ClerckMaxwell/6T-SRAM-Design-an-Reliability-Analysis/6T_SRAM_DESIGN.pdf

# Progettazione e Analisi di una Cella SRAM a 6T

### Raffaele Petrolo

## 1 Obiettivo dell’Analisi

Il presente elaborato riguarda la progettazione e la caratterizzazione di una cella SRAM a sei transistor (6T) in tecnologia CMOS 100 nm. L’analisi si focalizza sul compromesso tra robustezza statica (margini di rumore) e dissipazione di potenza, valutando l’impatto della scalabilit`a della tensione di alimentazione fino al limite del Data Retention Voltage (DRV).

## 2 Design della Cella e Sizing degli Inverter

### 2.1 Ricerca del punto di ottimo

Inizialmente si `e cercato di ottenere inverter interni quanto pi`u simmetrici possibile. Fissata la larghezza dei Pull-down al valore minimo Wn = 0.12 µm, `e stata eseguita una simulazione parametrica variando la larghezza Wp dei transistori di Pull-up.
L’obiettivo era centrare la soglia logica della transcaratteristica (VTC) a VDD/2 = 0.5 V .

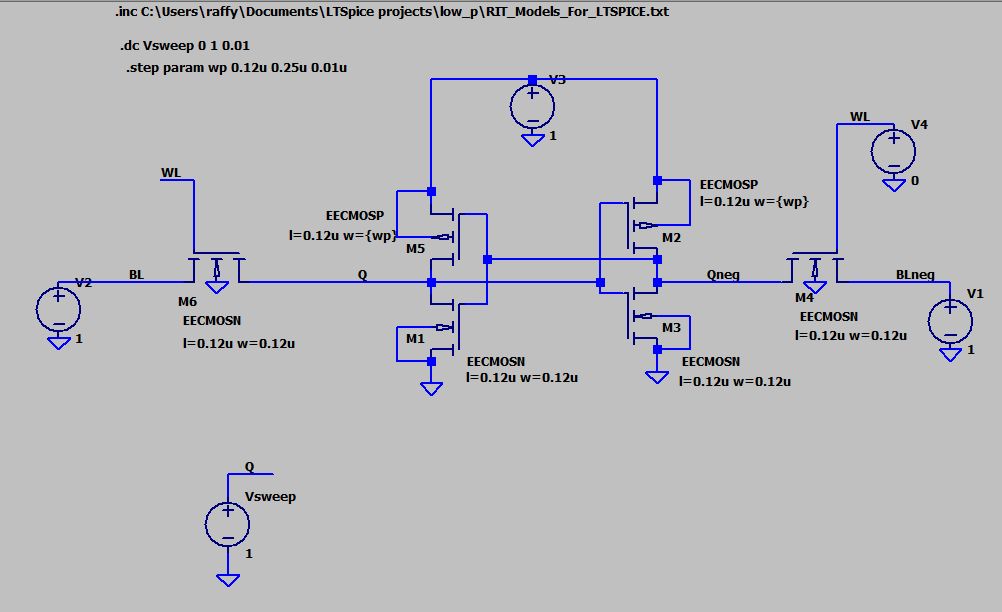
[picture p1: figure]

Figura 1: Schematico della cella 6T.

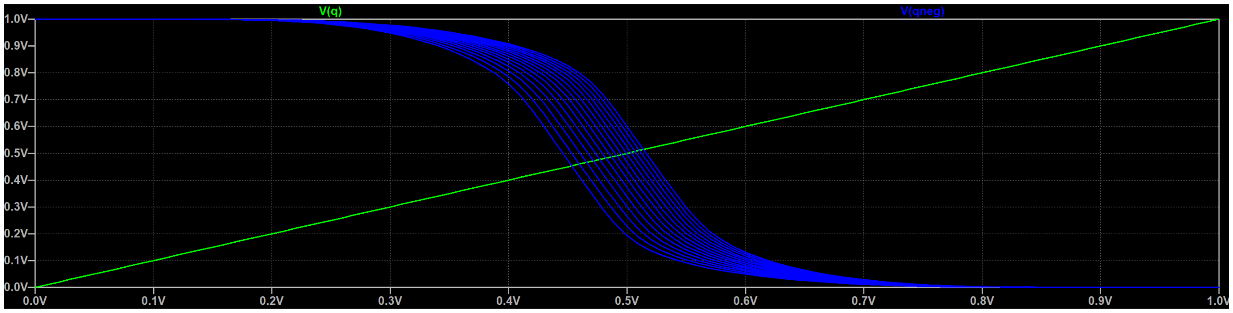
[picture p2: figure]

Figura 2: Simulazione parametrica di Wp.

Dall’analisi della Figura 2, il punto di commutazione ottimale `e stato individuato per:

| Wp = 0.21 µm
| Wn = 0.12 µm

## 3 Analisi della Stabilit`a Statica (SNM)

La stabilit`a della cella `e stata valutata tramite lo Static Noise Margin (SNM), definito come il lato del massimo quadrato inscrivibile nei lobi delle Butterfly Curves.

### 3.1 Metodologia di calcolo (Script MATLAB)

Per l’estrazione automatica dei margini di rumore, `e stato sviluppato uno script MATLAB basato sul metodo grafico della diagonale massima. Il cuore dell’algoritmo risiede nell’identificazione del massimo quadrato inscrivibile nei lobi della Butterfly Curve. Il procedimento logico-matematico `e il seguente:

1. Generazione delle curve: Partendo dai dati di simulazione (Vin, Vout), si definisce la prima curva V T C1 come y = f(x). La seconda curva V T C2, sfruttando la simmetria della cella, `e definita come l’inversa matematica x = f(y).
2. Scansione geometrica: Si considera il fascio di rette parallele alla bisettrice del primo e terzo quadrante, aventi equazione y = x + q. Per ogni valore dell’intercetta q, tale retta interseca le due curve in due punti distinti, P1 e P2.
3. Ricerca delle intersezioni: Lo script calcola per ogni punto della V T C1 il valore q = y − x. Successivamente, per un valore target di q, identifica:
| Il punto P1(x1, y1) sulla V T C1 tale per cui y1 − x1 = q.
| Il punto P2(x2, y2) sulla V T C2 tale per cui y2 − x2 = −q (sfruttando la simmetria
speculare delle curve rispetto alla bisettrice principale y = x).
4. Ottimizzazione della diagonale: La distanza euclidea d tra P1 e P2 rappresenta la diagonale di un quadrato con i lati paralleli agli assi coordinati. Lo script ricerca iterativamente il valore massimo di tale distanza (dmax) all’interno dei due lobi separatamente.
5. Calcolo dell’SNM: Poich´e in un quadrato di lato L la diagonale `e d = L

√
2, il margine
di rumore statico (Static Noise Margin) viene estratto come:

SNM =

dmax √
(1)

### 3.2 Analisi con dimensionamento iniziale

Inizialmente, la cella `e stata testata con il dimensionamento simmetrico ottenuto nel capitolo precedente (Wp = 0.21 µm, Wn = 0.12 µm) e transistor di accesso minimi (Wax = 0.12 µm). Le Figure 3a e 3b mostrano i quadrati di rumore ottenuti dallo script per le condizioni di Hold e Read.

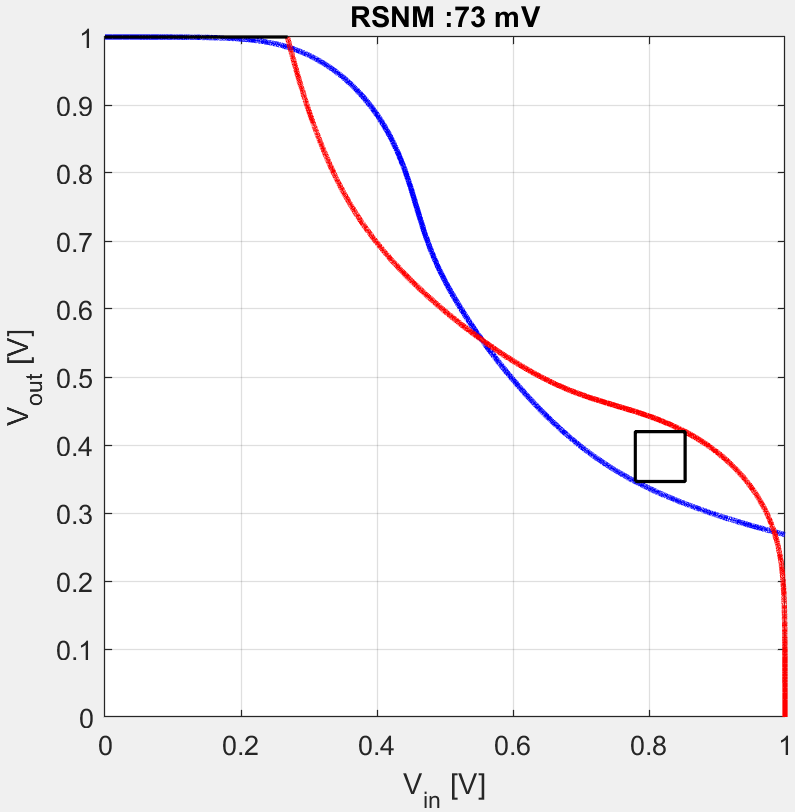
[picture p3: figure]
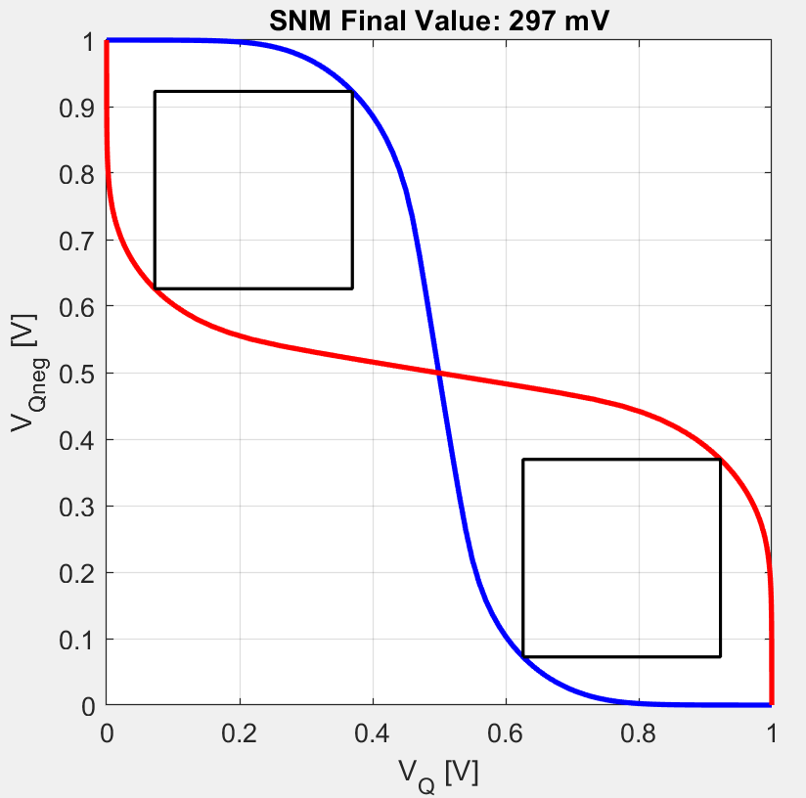
[picture p4: figure]

(a) HSNM (Hold). | (b) RSNM (Read).

Figura 3: Butterfly curves e quadrati inscritti con dimensionamento iniziale.

Sebbene l’HSNM risulti adeguato (≈ 297 mV ), l’RSNM `e troppo basso, circa 73 mV . Questa fragilit`a `e dovuta al partitore di tensione formato tra il transistor di accesso e il Pull-down durante la lettura.

### 3.3 Ottimizzazione del Beta Ratio

Per migliorare il margine di Read, si `e inizialmente valutato l’impatto di Wp. Tuttavia, i risultati mostrano che per ottenere un guadagno significativo nel margine di Read sarebbe necessario quadruplicare la larghezza del Pull-up, con un beneficio complessivo molto ridotto (Figura 4).

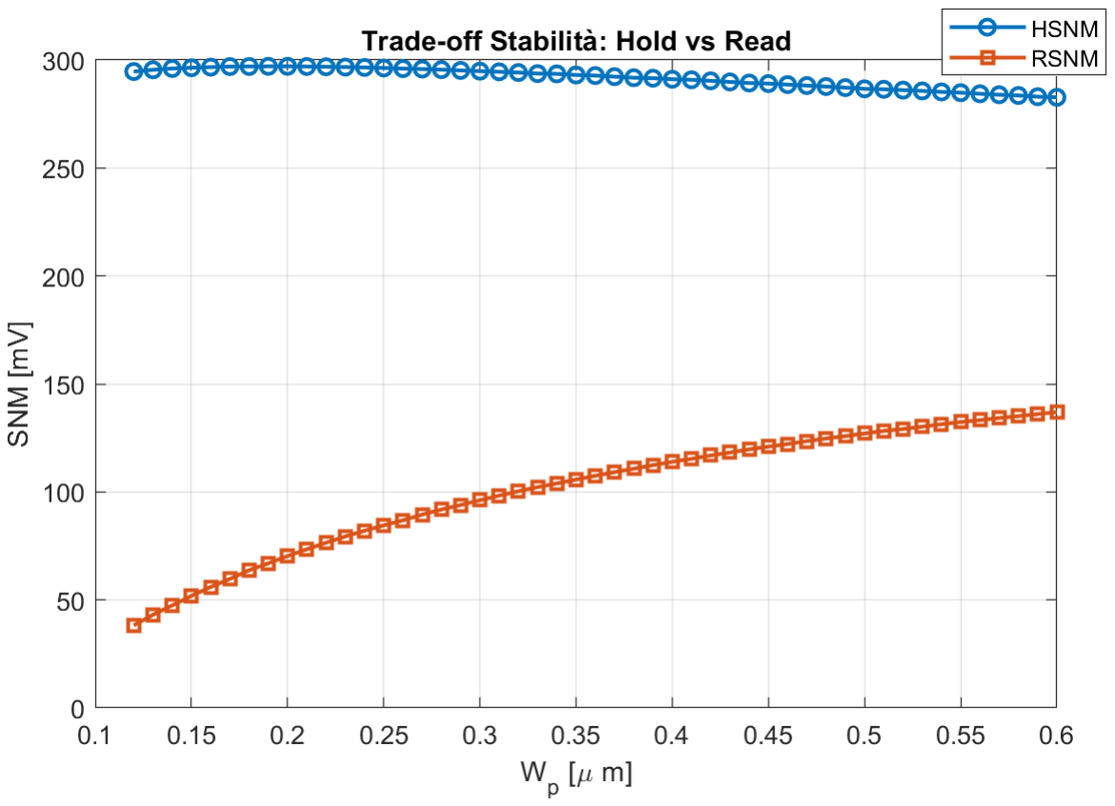
[picture p5: figure]

Figura 4: Andamento di HSNM e RSNM al variare di Wp.

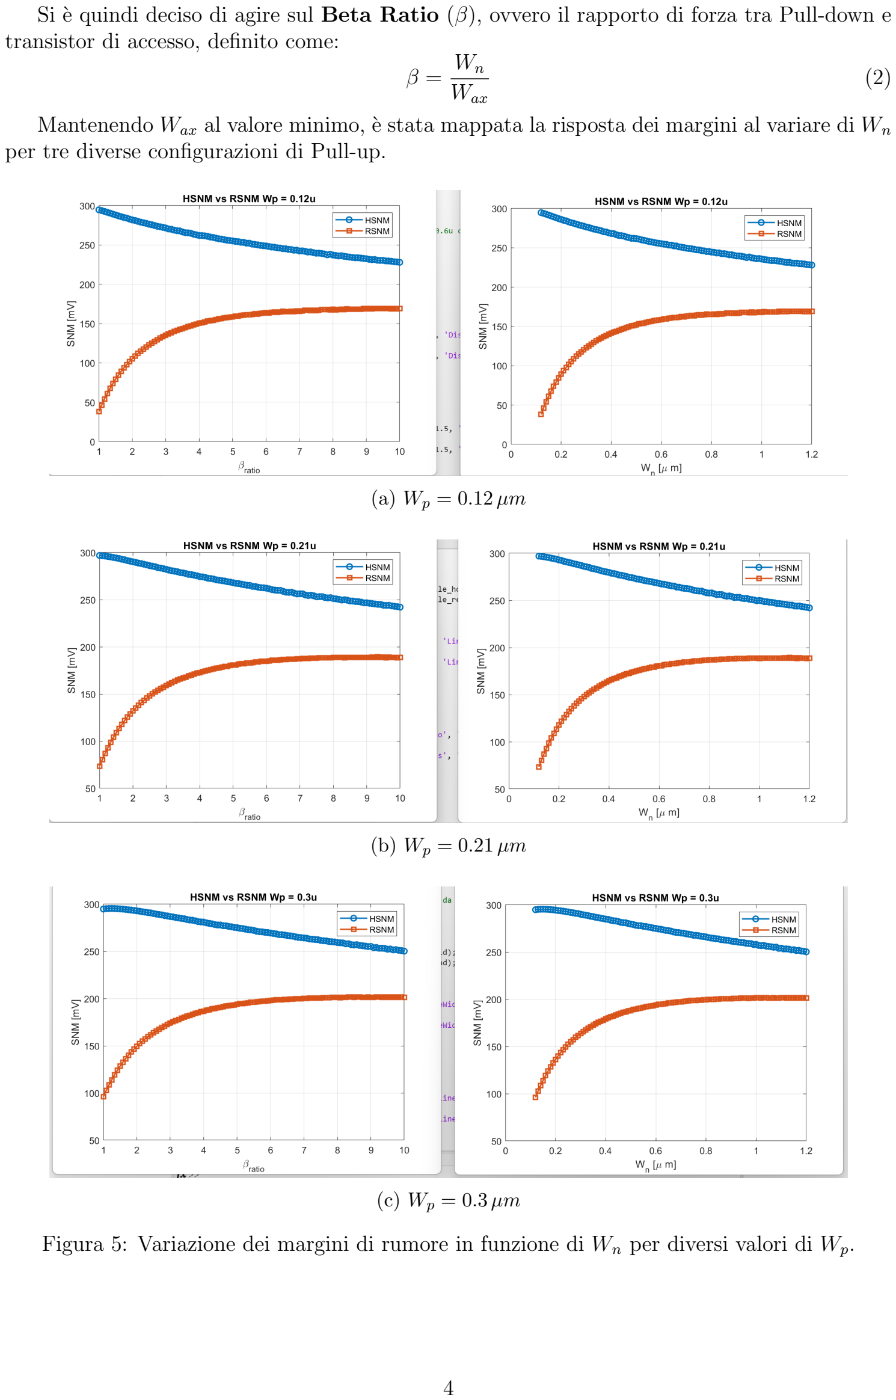
[picture p6: page 4]

Si `e quindi deciso di agire sul Beta Ratio (β), ovvero il rapporto di forza tra Pull-down e transistor di accesso, definito come:

β =

Wn

Wax

(2)

Mantenendo Wax al valore minimo, `e stata mappata la risposta dei margini al variare di Wn per tre diverse configurazioni di Pull-up.

(a) Wp = 0.12 µm
(b) Wp = 0.21 µm
(c) Wp = 0.3 µm

Figura 5: Variazione dei margini di rumore in funzione di Wn per diversi valori di Wp.

### 3.4 Scelta del dimensionamento ottimale

Dall’analisi comparativa `e emerso che l’incremento di Wp produce un offset positivo sull’RSNM estremamente ridotto a fronte di un aumento considerevole dell’area occupata. Si `e quindi scelto di mantenere il Pull-up al valore minimo tecnologico, Wp = 0.12 µm, per minimizzare l’ingombro della cella.
Per quanto riguarda il Pull-down, l’andamento dell’RSNM in funzione di Wn mostra un comportamento di tipo sub-lineare, riconducibile a una funzione radice quadrata. Per individuare il punto di massima efficacia del dimensionamento, `e stata calcolata la derivata prima dell’RSNM rispetto a Wn (Figura 6).

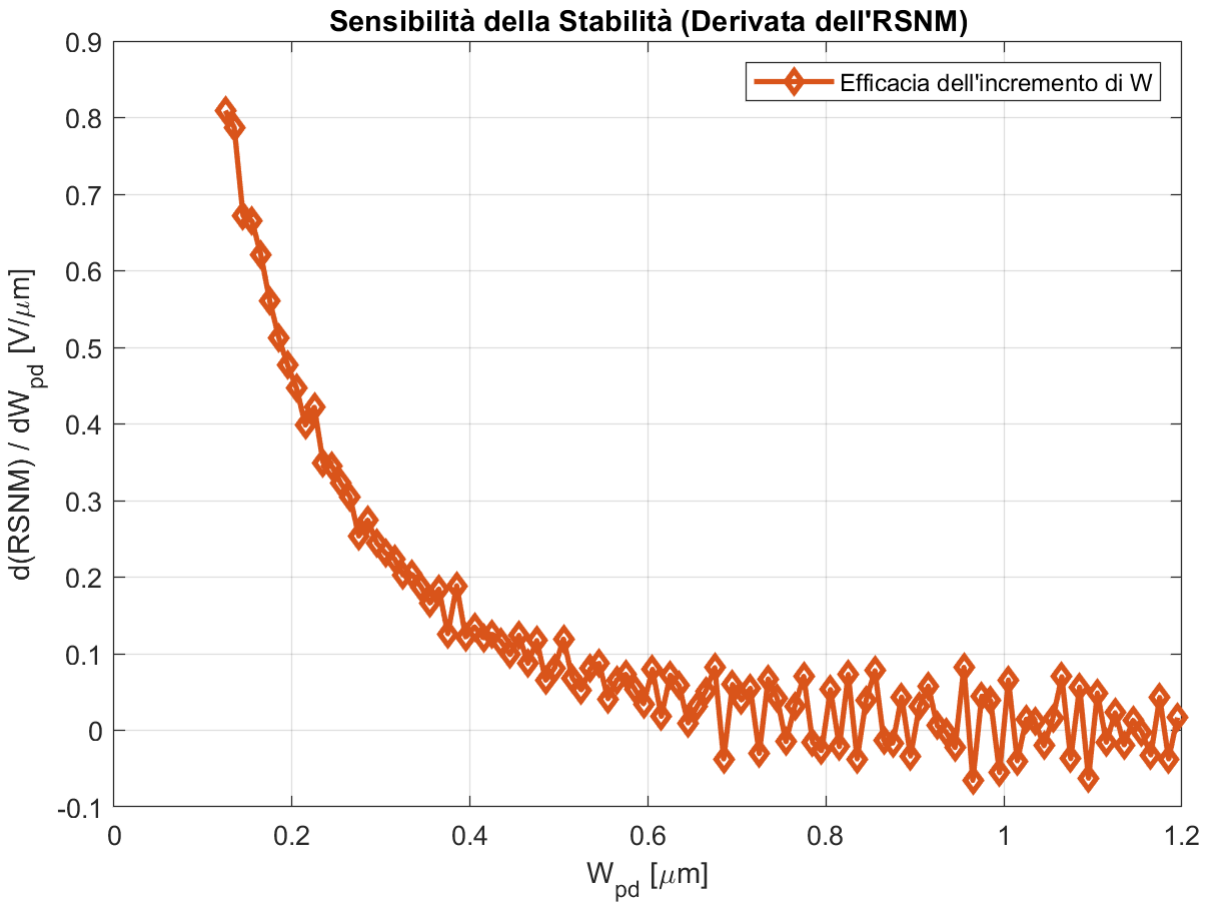
[picture p7: figure]

Figura 6: Derivata dell’RSNM rispetto a Wn. L’andamento tipico 1/

√
x conferma che i maggiori
benefici in termini di stabilit`a si ottengono per piccoli incrementi di Wn nel range iniziale.

Il grafico della derivata mostra chiaramente che la sensibilit`a del margine di rumore cala drasticamente all’aumentare della larghezza del canale. Si `e quindi individuato un punto di lavoro a Wn = 0.375 µm, che rappresenta un buon compromesso tra robustezza statica e densit`a di integrazione.

### 3.5 Impatto dei transistor di accesso e validazione del modello

Completata l’analisi sui transistor interni, si `e valutato l’impatto della larghezza dei transistor di accesso (Wax). Come previsto dalla teoria del Beta Ratio, un incremento di Wax comporta inizialmente un drastico peggioramento dell’RSNM (Figura 7).

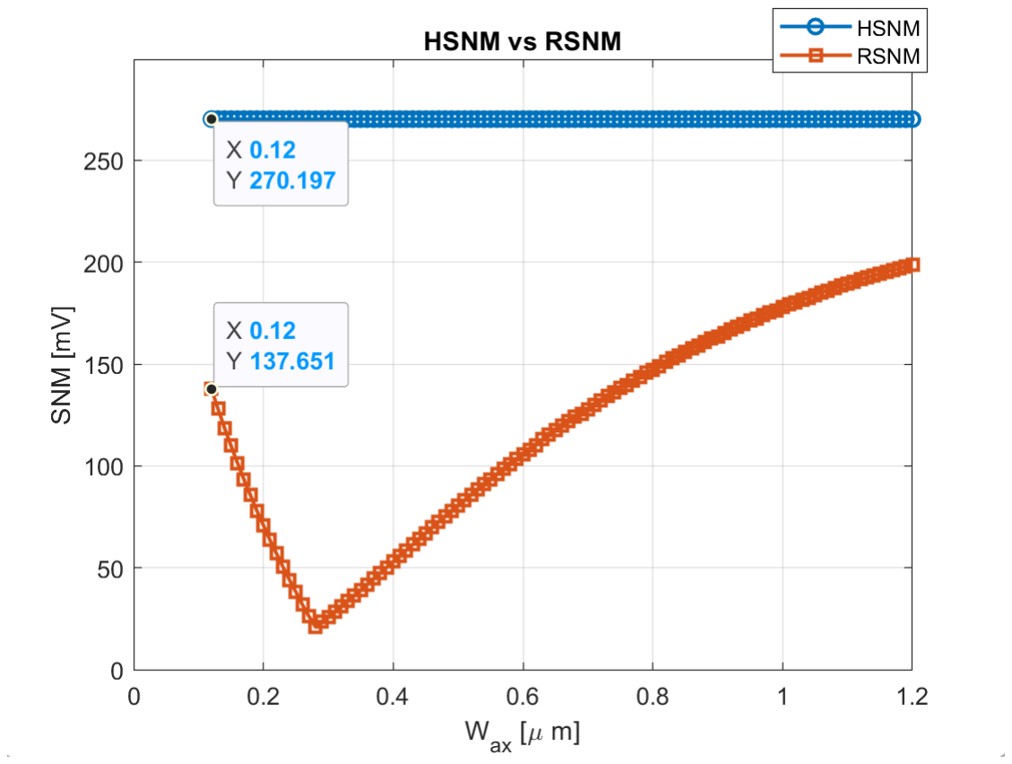
[picture p8: figure]

Figura 7: Degradazione dell’RSNM all’aumentare della larghezza dei transistor di accesso Wax.

Osservando la Figura 7, si nota un comportamento singolare: superato il punto critico in cui Wax ≈ Wn, il margine calcolato dallo script MATLAB sembra apparentemente migliorare. Tuttavia, tale incremento `e un falso positivo dovuto alla natura puramente geometrica dell’algoritmo.
Quando l’accesso diventa eccessivamente forte rispetto al Pull-down, la cella perde la sua caratteristica bistabile e le curve a farfalla si deformano al punto da non incrociarsi pi`u correttamente per formare i due lobi. Lo script continua a ricercare la massima distanza euclidea tra le curve, identificando un valore numerico elevato che per`o non rappresenta pi`u una condizione di stabilit`a, bens`ı la transizione verso un regime monostabile dove il dato viene sovrascritto dalla Bitline (read-destructive event). Per tale ragione, si `e confermato il valore minimo tecnologico Wax = 0.12 µm.
Il design finale della cella per ora presenta quindi i seguenti parametri nominali: Wp = 0.12 µm, Wn = 0.375 µm e Wax = 0.12 µm. Con tale configurazione, i margini calcolati tramite lo script MATLAB risultano:
| HSNM: 270.2 mV
| RSNM: 137.65 mV

Per validare l’accuratezza dell’algoritmo MATLAB, `e stata eseguita una verifica comparativa utilizzando il metodo di Seevnick in LTspice. Le Figure 8 e 9 mostrano la perfetta coincidenza tra i valori estratti graficamente e quelli simulati, confermando la solidit`a della procedura.

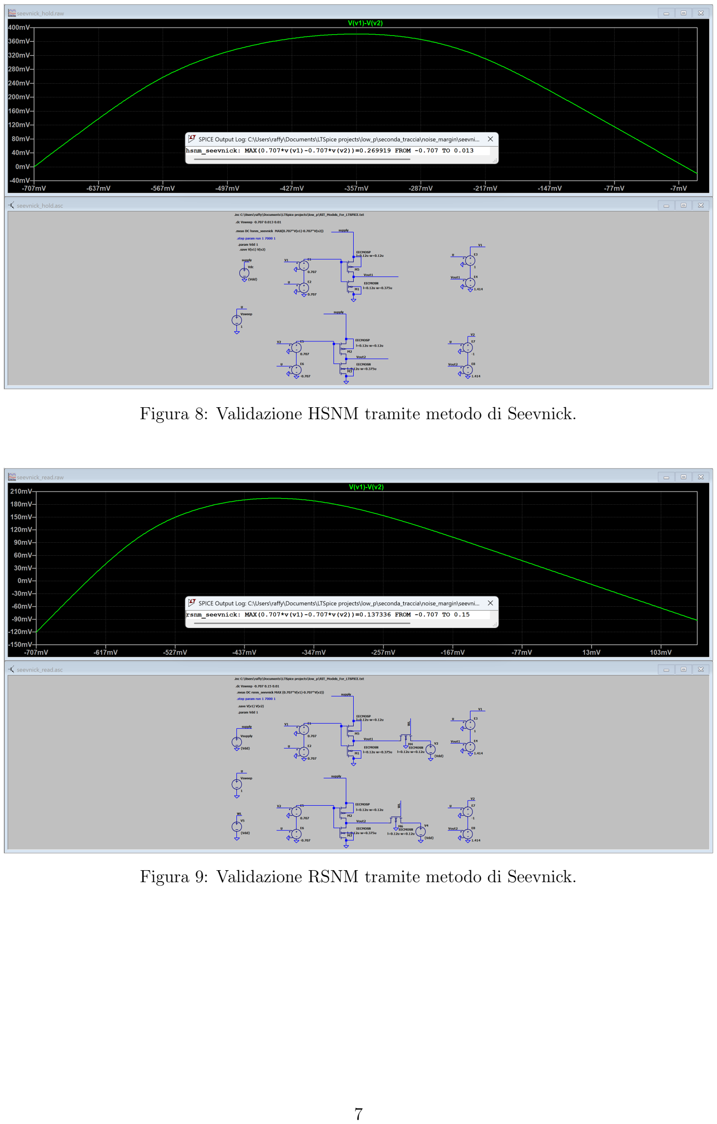
[picture p9: page 7]

Figura 8: Validazione HSNM tramite metodo di Seevnick.

Figura 9: Validazione RSNM tramite metodo di Seevnick.

## 4 Analisi statistica e Scaling della Tensione di Alimentazione

In questo capitolo viene analizzata la robustezza della cella SRAM considerando uno scaling della tensione VDD da 1 V a 0.2 V (con passi di 0.1 V ). Per ciascun valore sono state eseguite 7000 simulazioni Monte Carlo, applicando una variazione gaussiana alle tensioni di soglia (Vth) dei transistor per modellare le variazioni di processo inter-die.
L’obiettivo `e identificare il limite di funzionamento della cella, fissando una soglia critica di sicurezza SNMmin = 60 mV .

### 4.1 Ottimizzazione finale del dimensionamento

L’analisi statistica condotta sul dimensionamento precedentemente individuato (Wn = 0.375 µm) ha evidenziato una criticit`a: gi`a alla tensione nominale di 1 V , si `e riscontrato che una cella (quindi 1 su 7000) presentava un RSNM inferiore alla soglia di sicurezza di 60 mV .

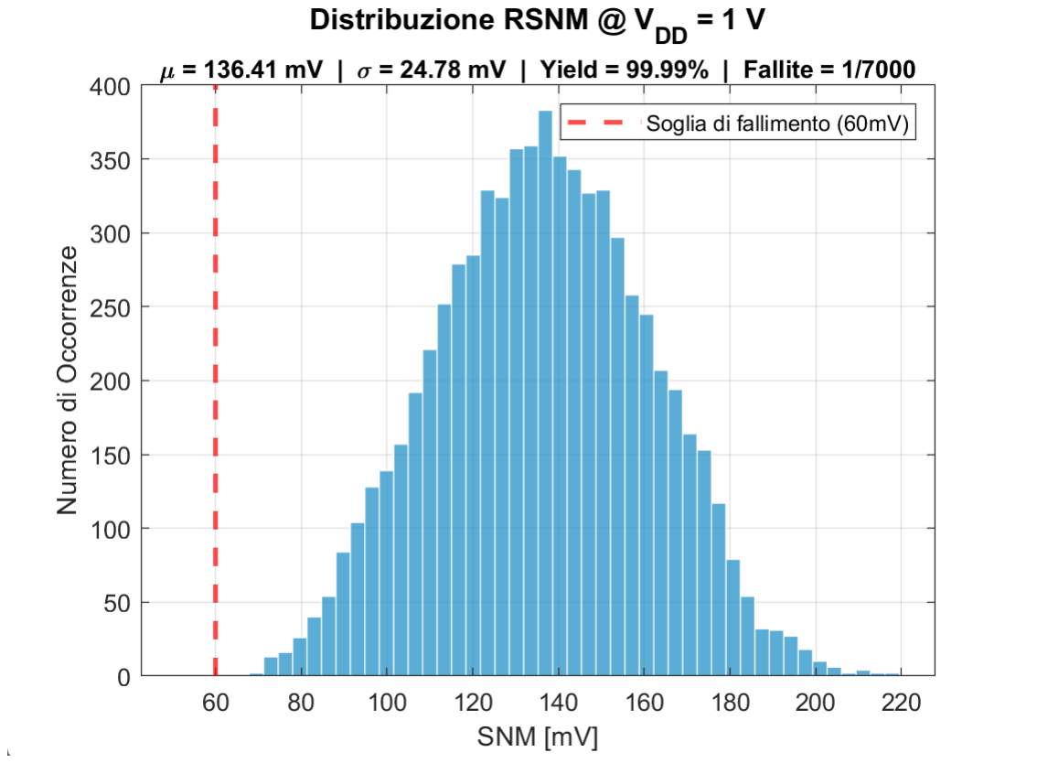
[picture p10: figure]

Per garantire quindi un yield elevato, si `e deciso di incrementare ulteriormente il Beta Ratio, spostandosi sulla curva di sensibilit`a precedentemente calcolata verso un valore di Wn = 0.5 µm.

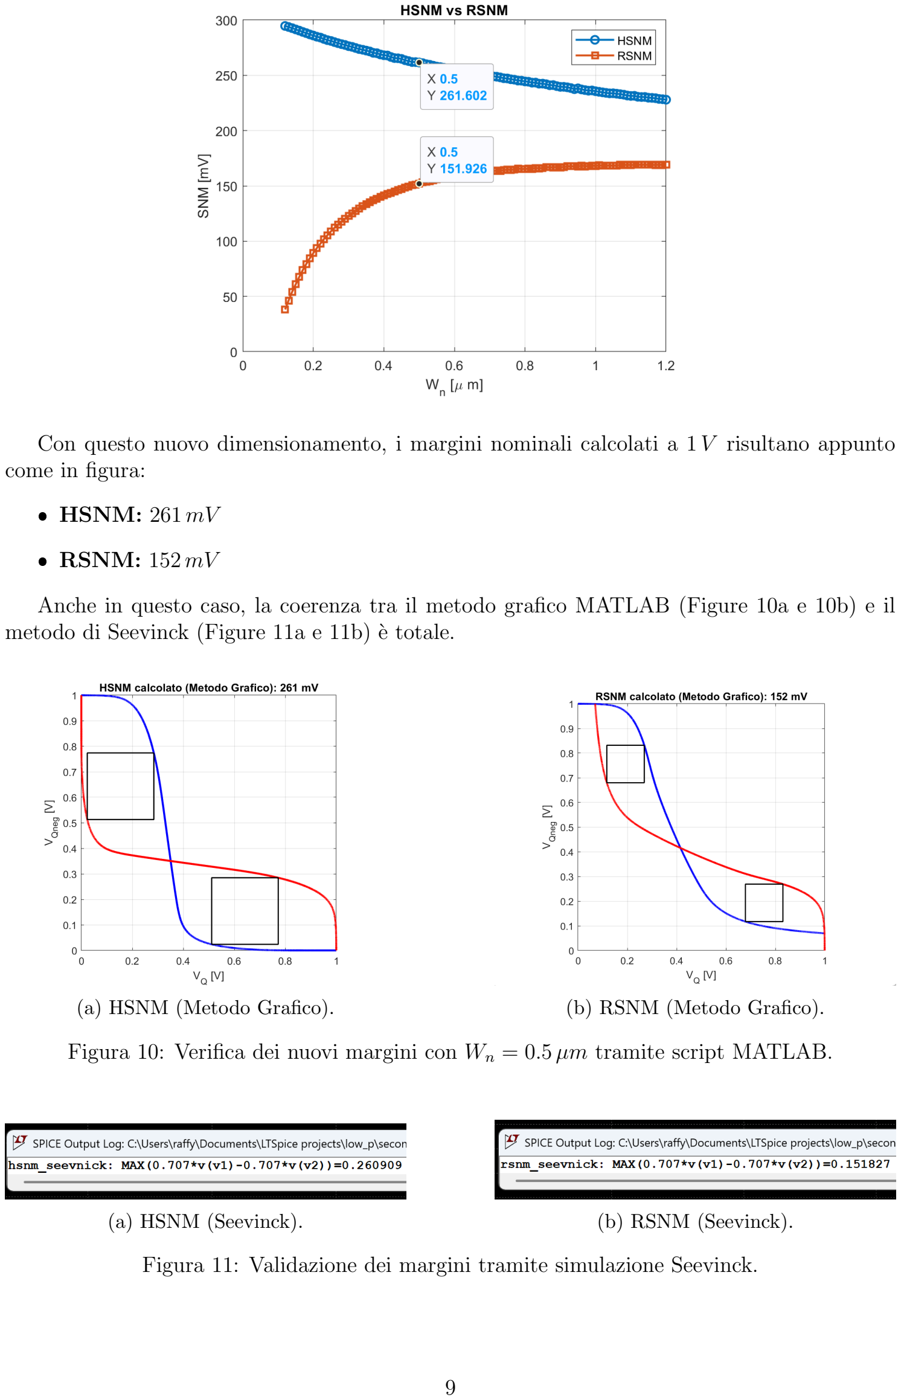
[picture p11: page 9]

Con questo nuovo dimensionamento, i margini nominali calcolati a 1 V risultano appunto come in figura:

| HSNM: 261 mV
| RSNM: 152 mV

Anche in questo caso, la coerenza tra il metodo grafico MATLAB (Figure 10a e 10b) e il metodo di Seevinck (Figure 11a e 11b) `e totale.

(a) HSNM (Metodo Grafico). | (b) RSNM (Metodo Grafico).

Figura 10: Verifica dei nuovi margini con Wn = 0.5 µm tramite script MATLAB.

(a) HSNM (Seevinck). | (b) RSNM (Seevinck).

Figura 11: Validazione dei margini tramite simulazione Seevinck.

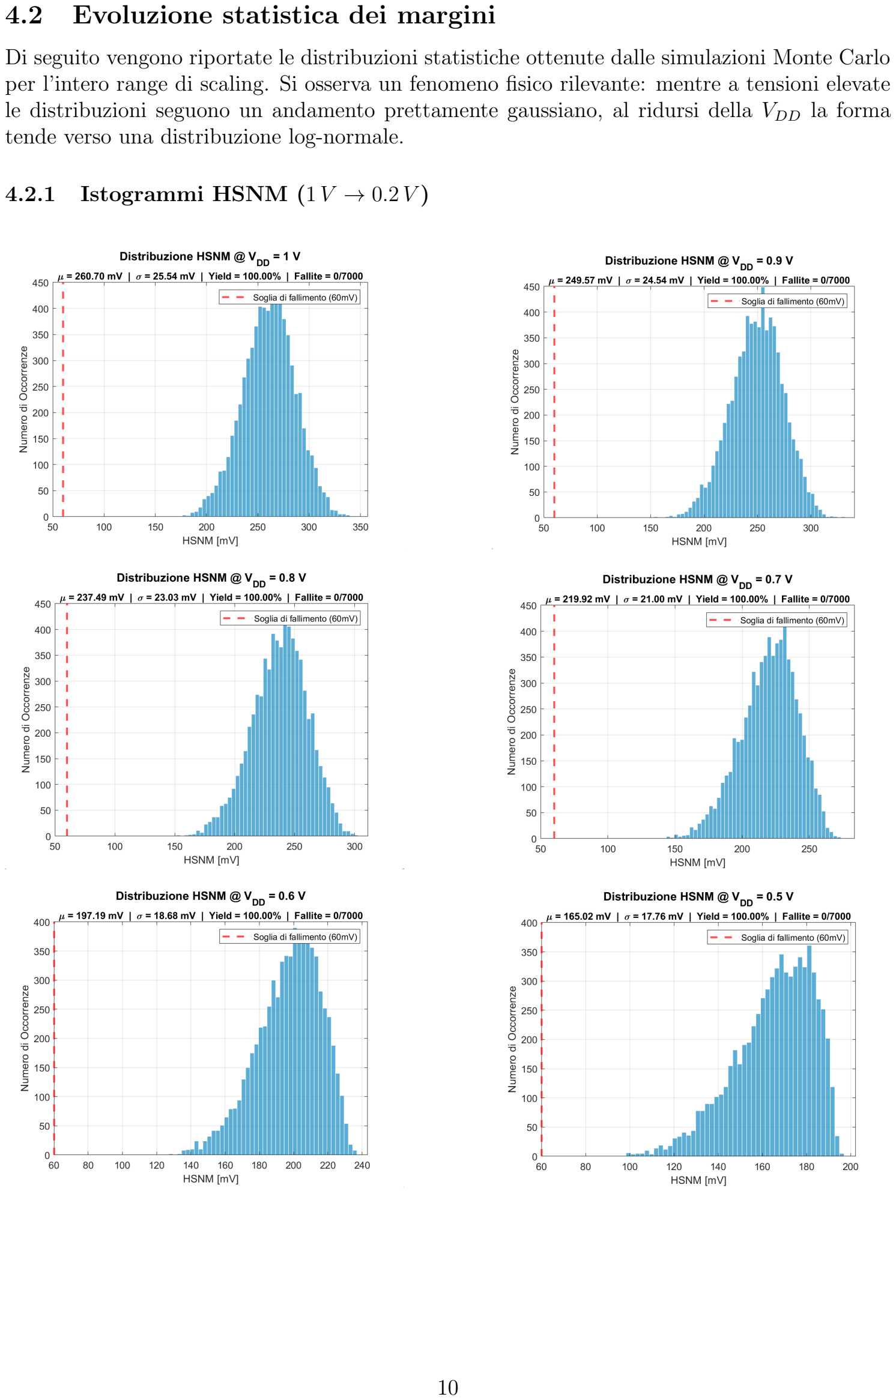
[picture p12: page 10]

### 4.2 Evoluzione statistica dei margini

Di seguito vengono riportate le distribuzioni statistiche ottenute dalle simulazioni Monte Carlo per l’intero range di scaling. Si osserva un fenomeno fisico rilevante: mentre a tensioni elevate le distribuzioni seguono un andamento prettamente gaussiano, al ridursi della VDD la forma tende verso una distribuzione log-normale.

### 4.2.1 Istogrammi HSNM (1 V → 0.2 V )

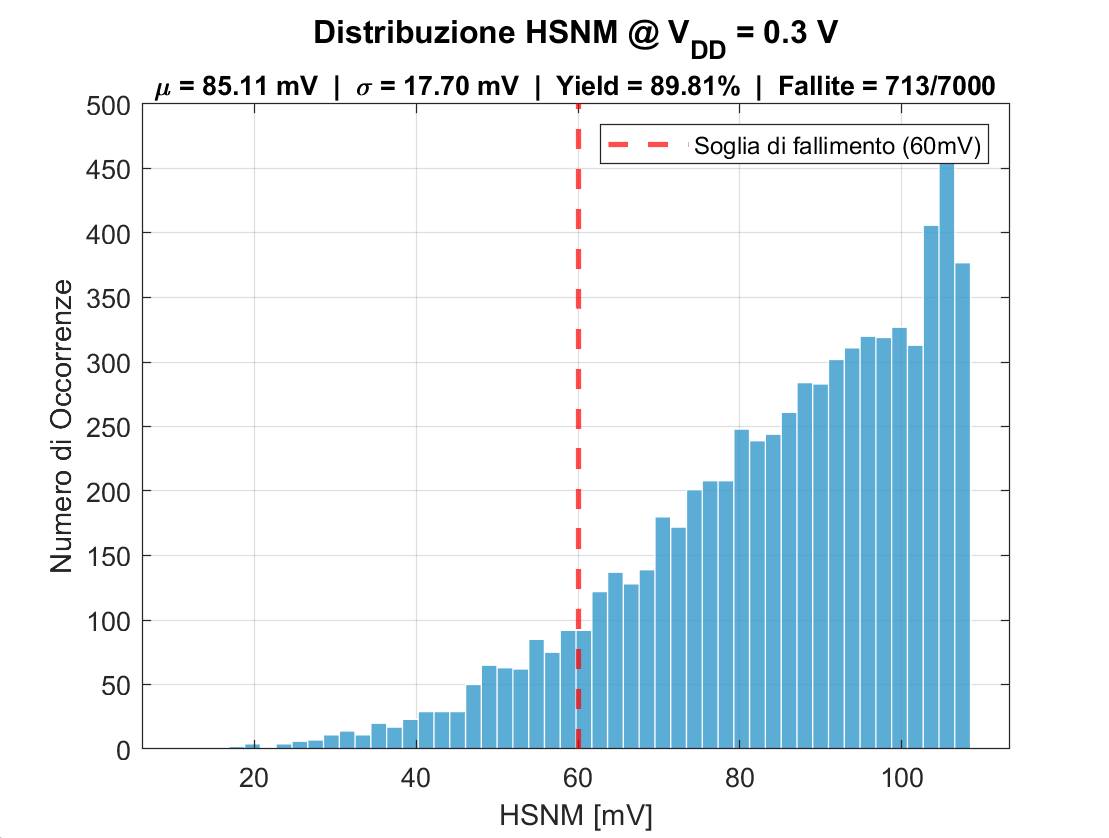
[picture p13: figure]
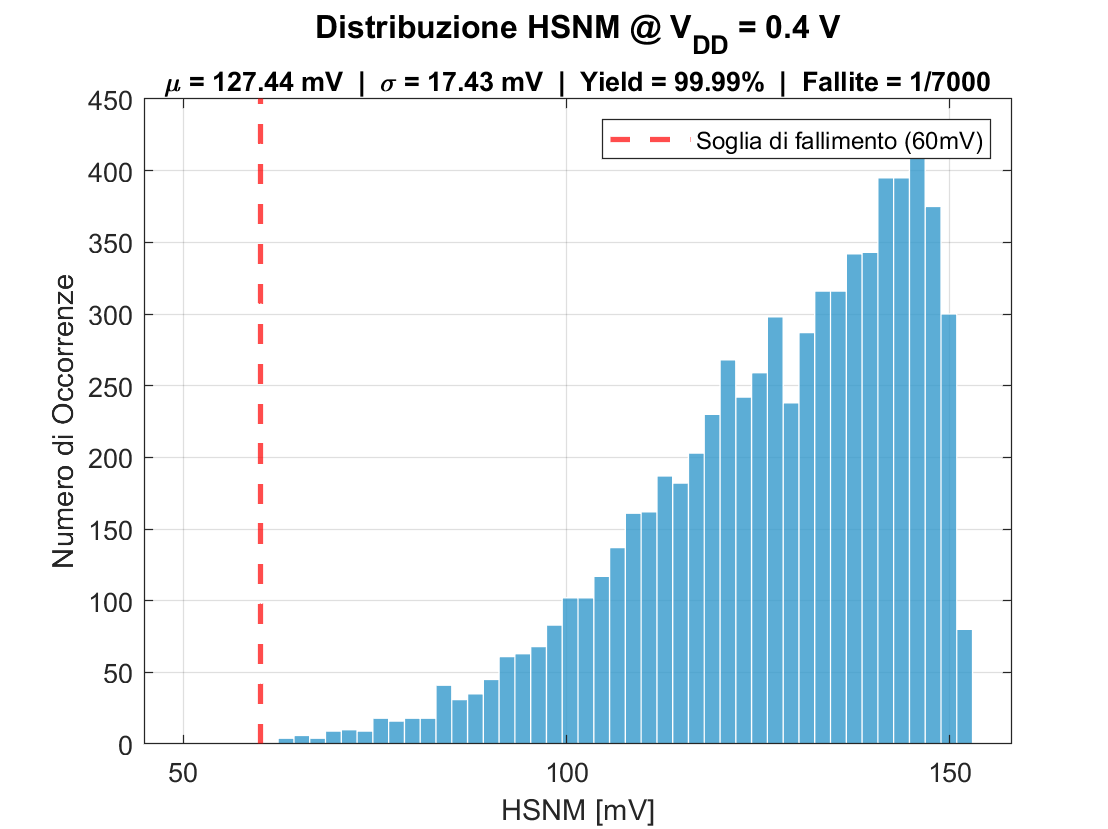
[picture p14: figure]
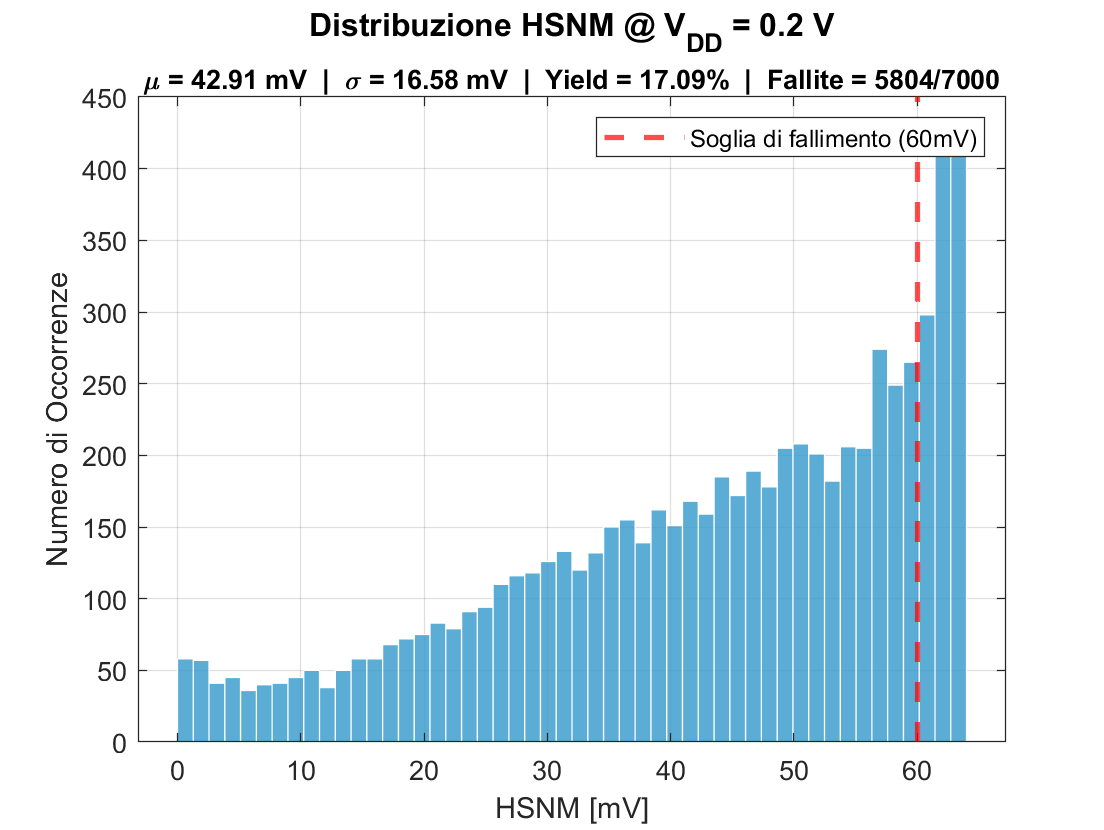
[picture p15: figure]

Figura 13: Distribuzioni Monte Carlo HSNM (1V - 0.2V ).

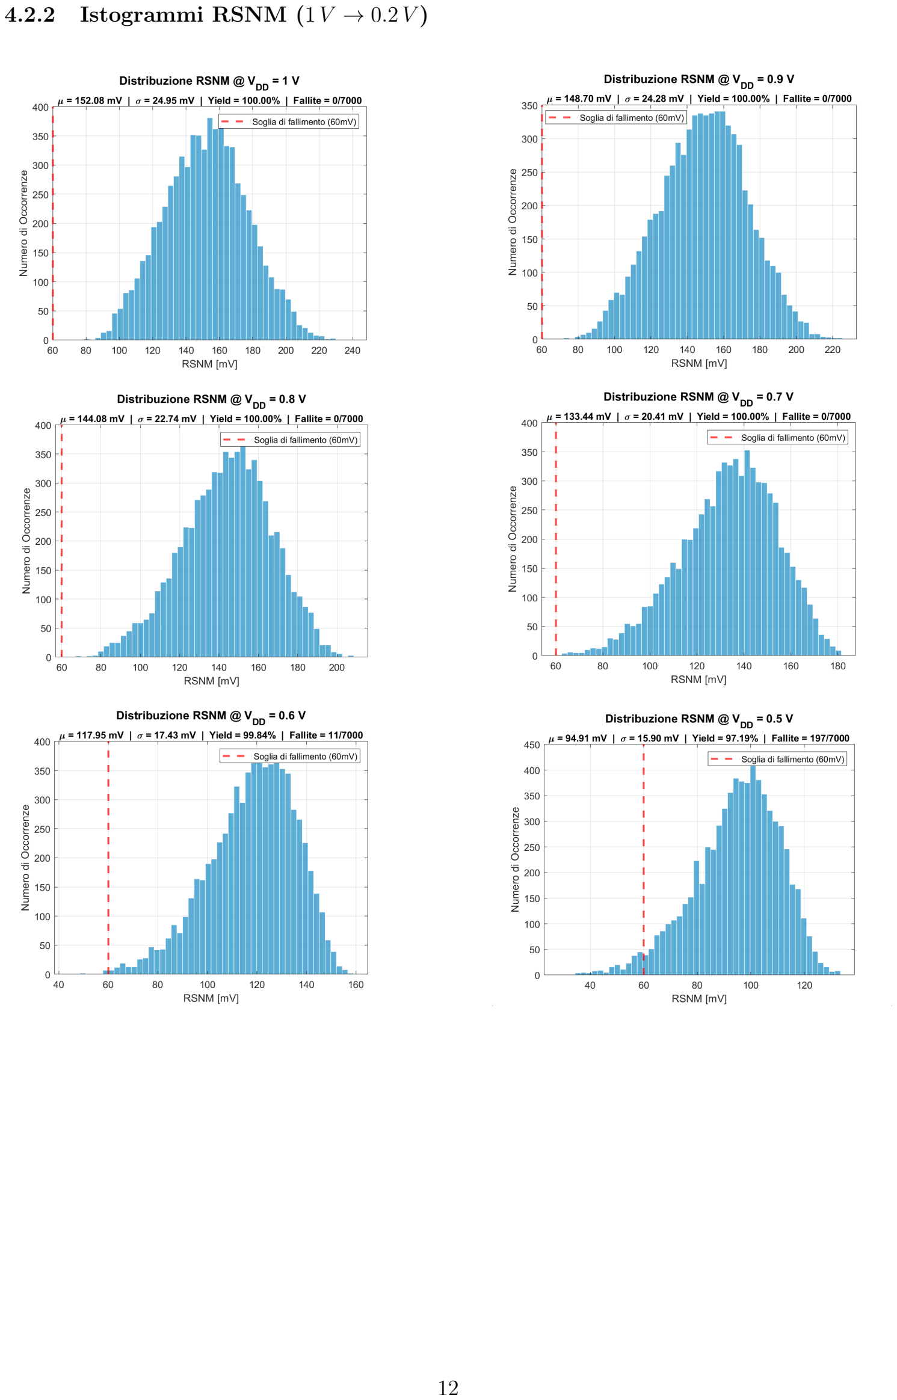
[picture p16: page 12]

### 4.2.2 Istogrammi RSNM (1 V → 0.2 V )

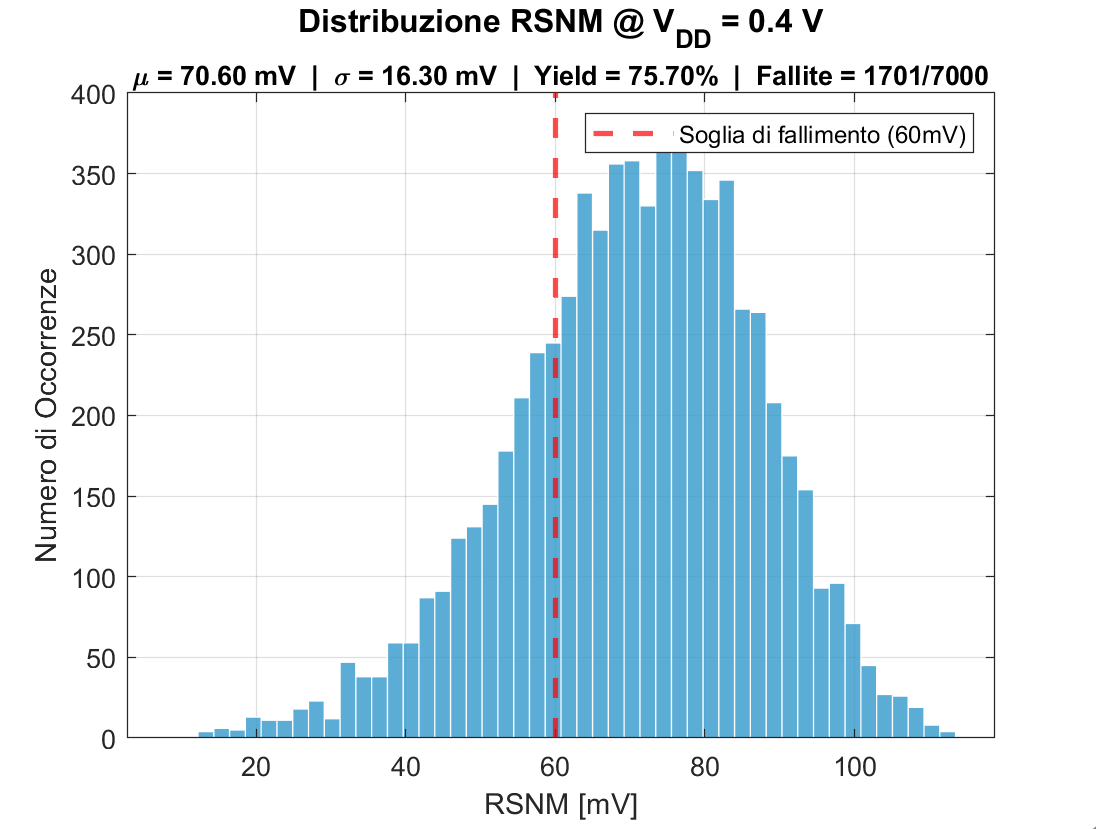
[picture p17: figure]
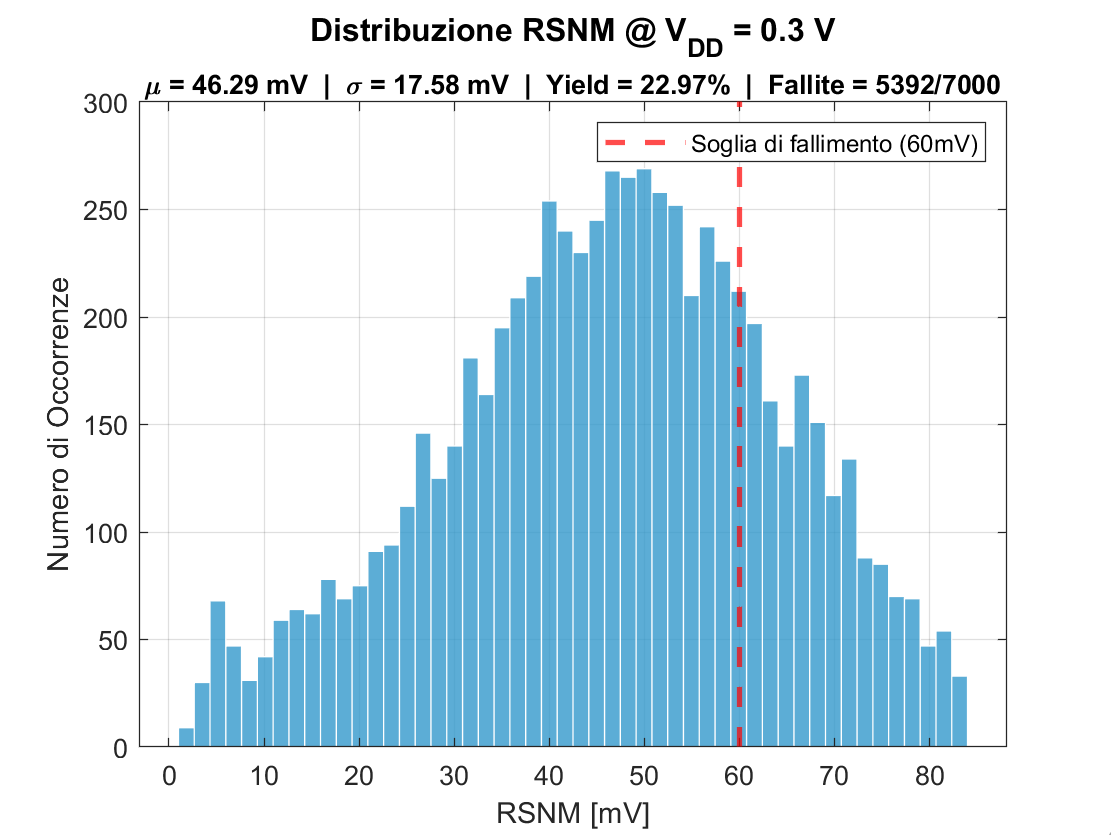
[picture p18: figure]
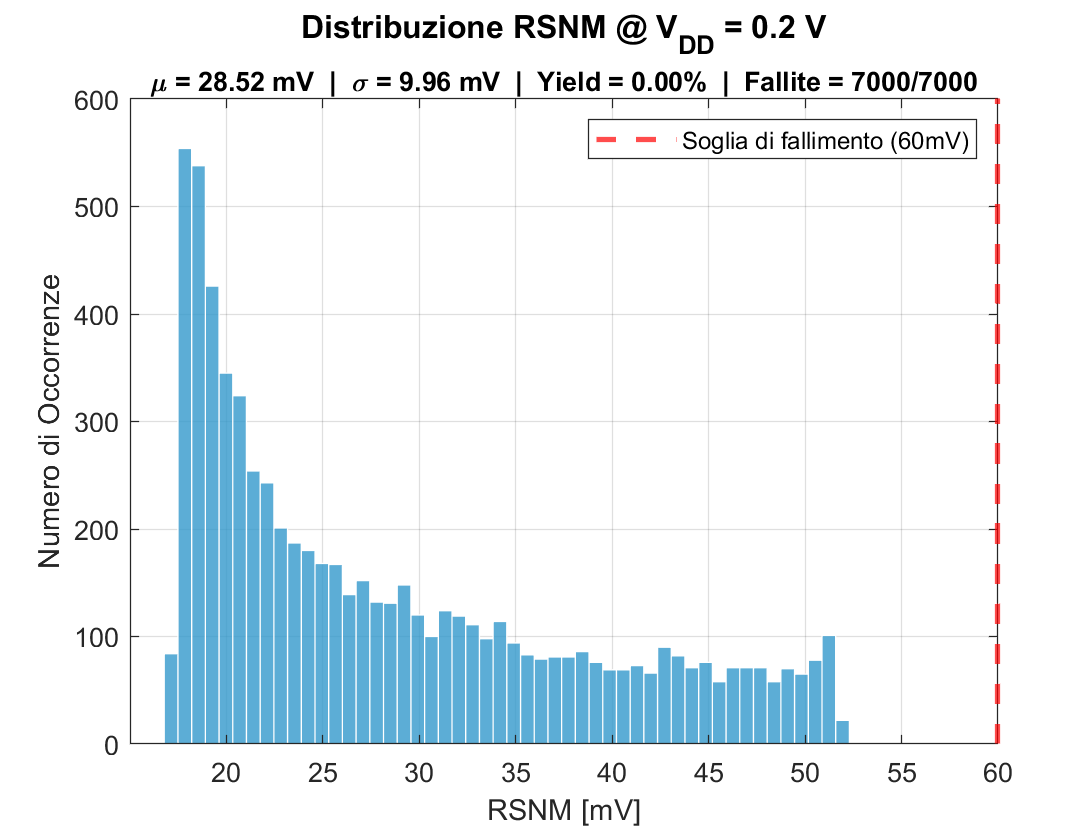
[picture p19: figure]

Figura 15: Distribuzioni Monte Carlo RSNM (1V - 0.2V ).

### 4.3 Analisi delle correnti e della potenza di leakage

Per analizzare il consumo statico della cella, `e stata condotta una simulazione in transitorio articolata in due fasi. Inizialmente `e stato forzato il caricamento di un dato logico all’interno della cella; successivamente, il circuito `e stato portato in fase di hold (Wordline a 0 V e Bitline a VDD). La lettura delle correnti di leakage `e stata effettuata al termine del transitorio, garantendo che i nodi fossero in regime stazionario.
La corrente di leakage totale della cella `e stata calcolata come somma dei contributi dei singoli transistor interdetti, come mostrato nello schematico di Figura 16:
| IP U : corrente sul PMOS di Pull-up spento (M2).
| IP D: corrente sull’NMOS di Pull-down spento (M1).
| IAX: corrente sull’NMOS di accesso spento (M4).

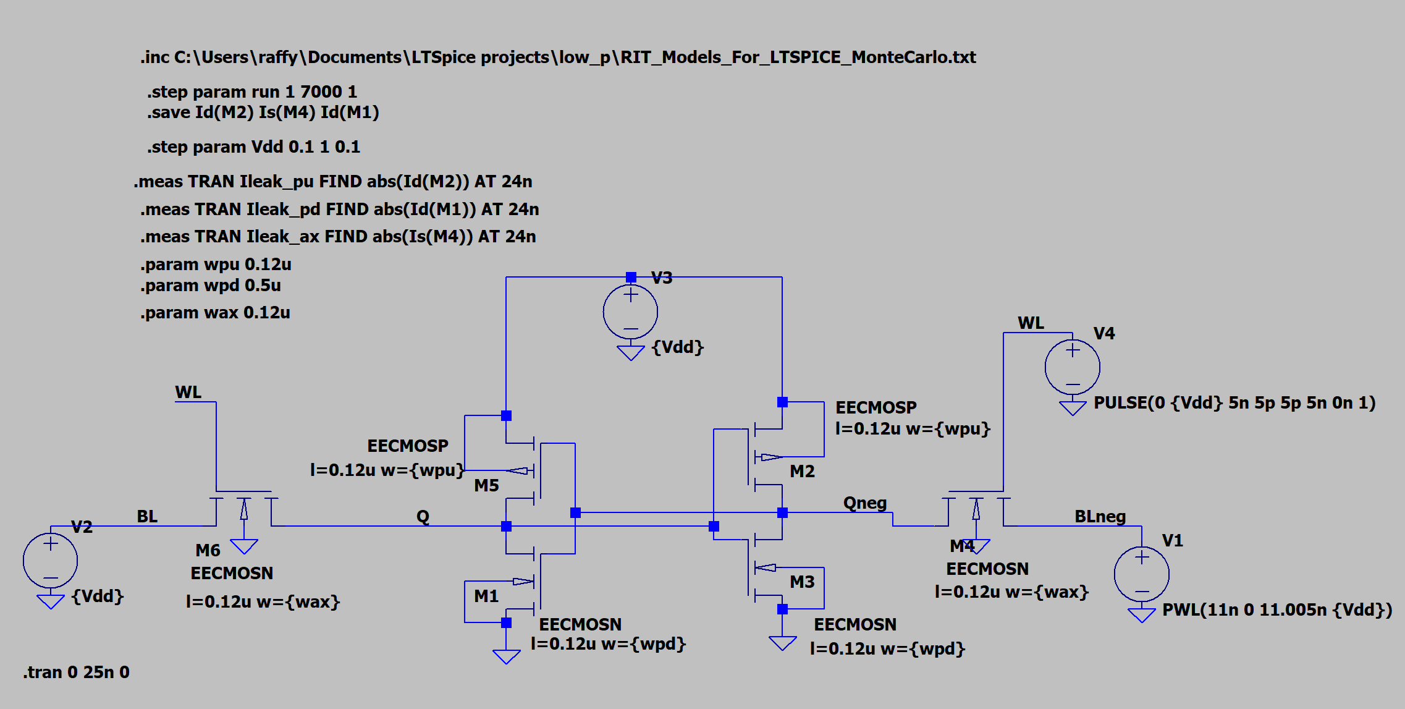
[picture p20: figure]

Figura 16: Configurazione circuitale per l’estrazione delle componenti di leakage.

### 4.3.1 Distribuzioni statistiche delle correnti (1 V → 0.1 V )

Le simulazioni Monte Carlo rivelano come il leakage sia fortemente influenzato dalle variazioni della soglia (Vth). Di seguito si riportano le distribuzioni statistiche scendendo nel regime di sottosoglia; si nota come, con il diminuire della tensione, la dispersione statistica aumenti sensibilmente.

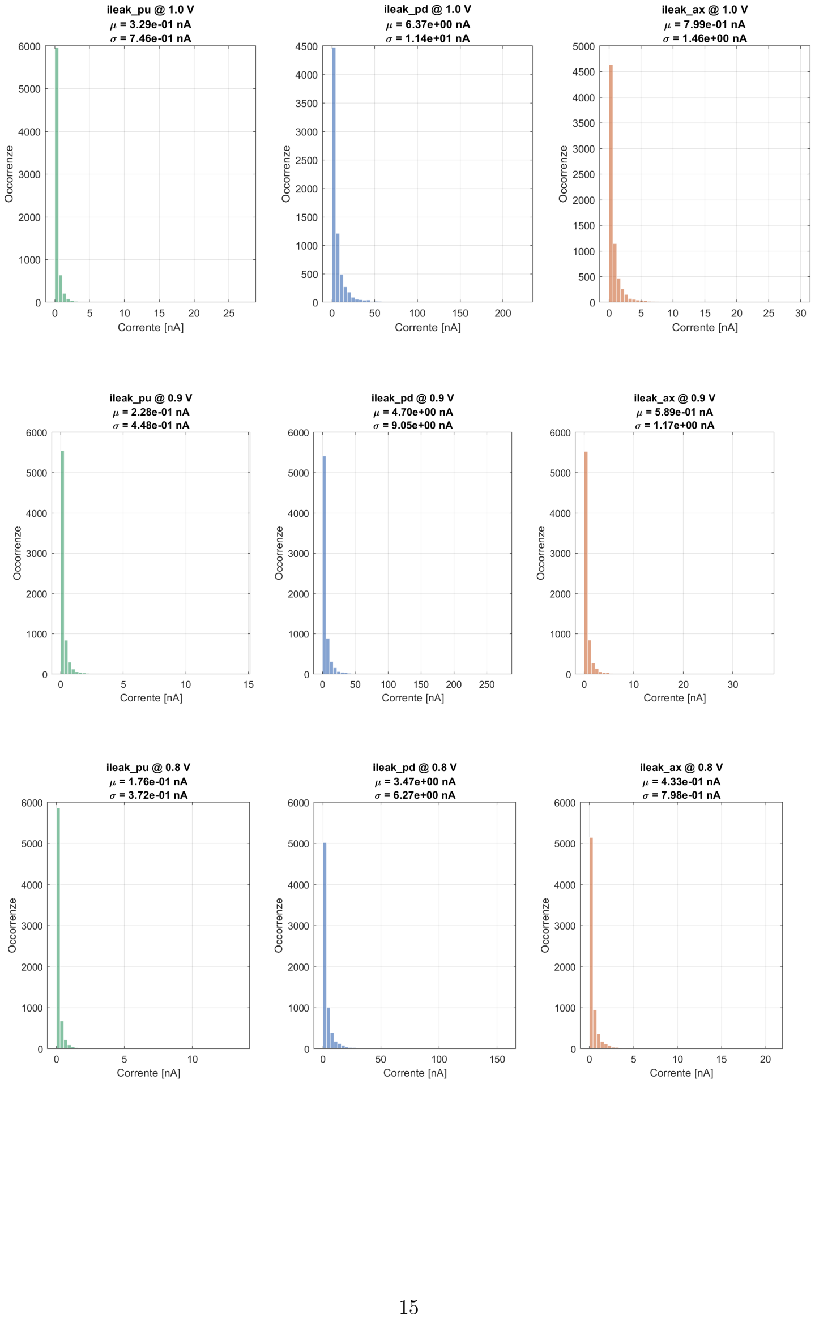
[picture p21: page 15]
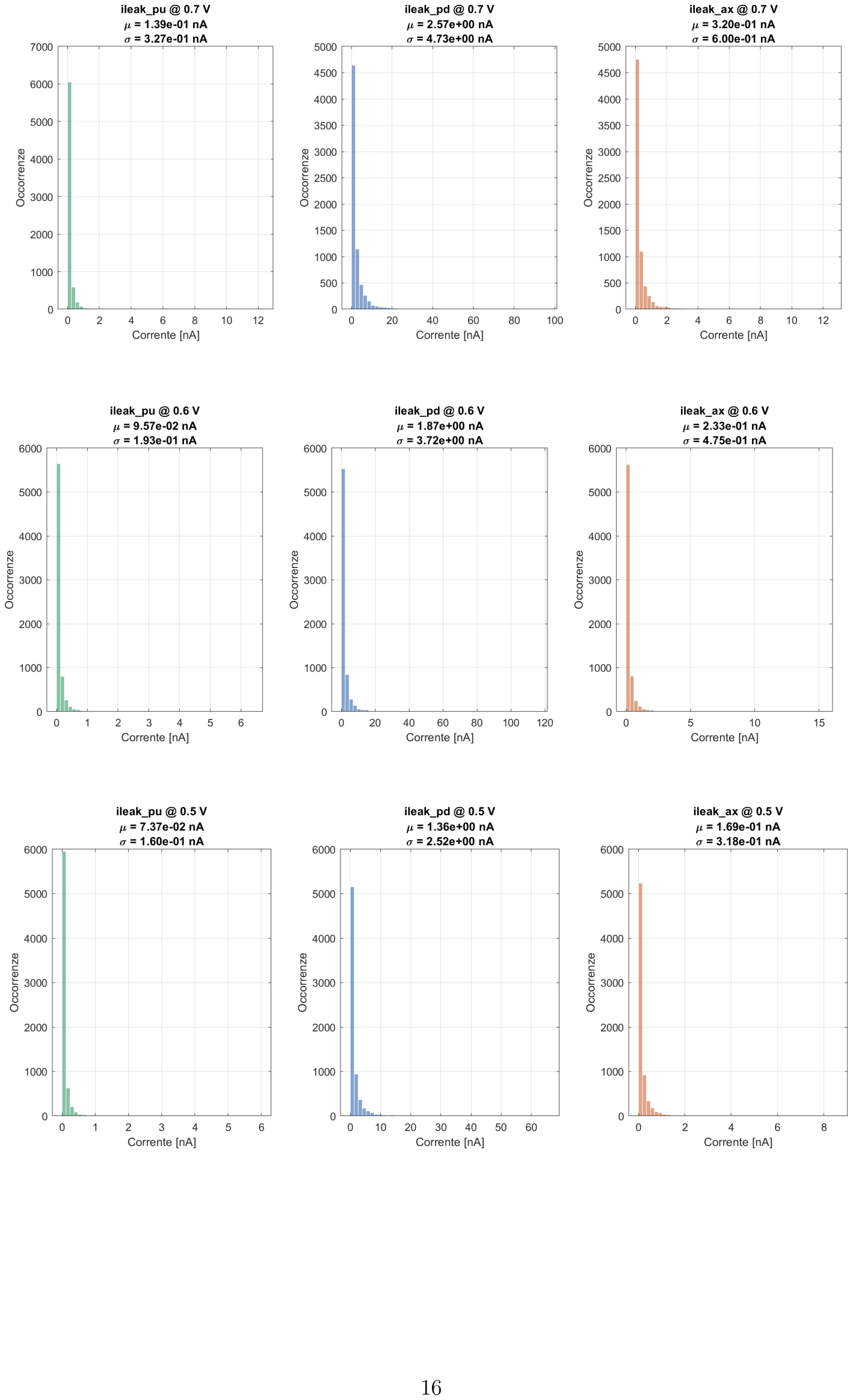
[picture p22: page 16]
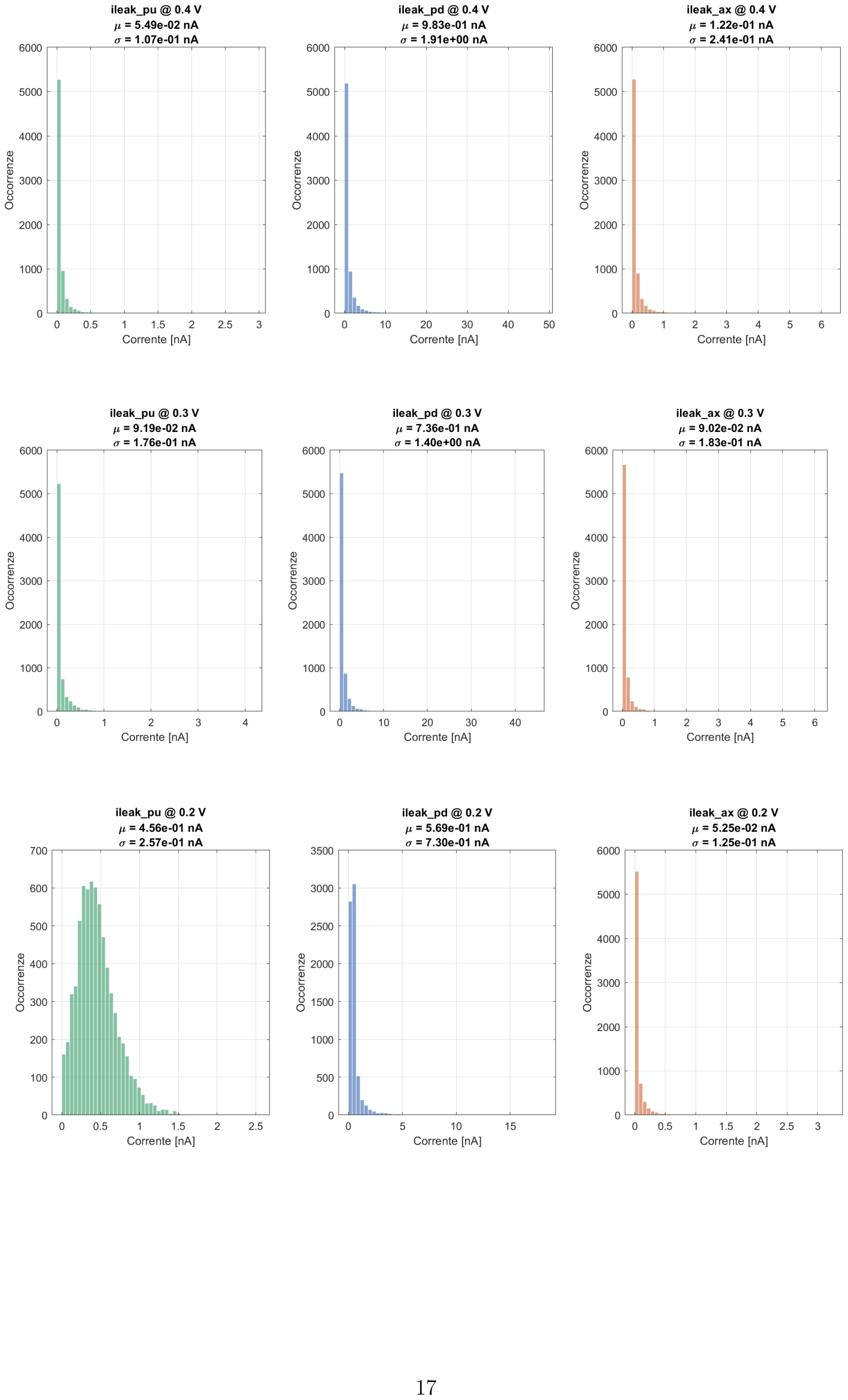
[picture p23: page 17]

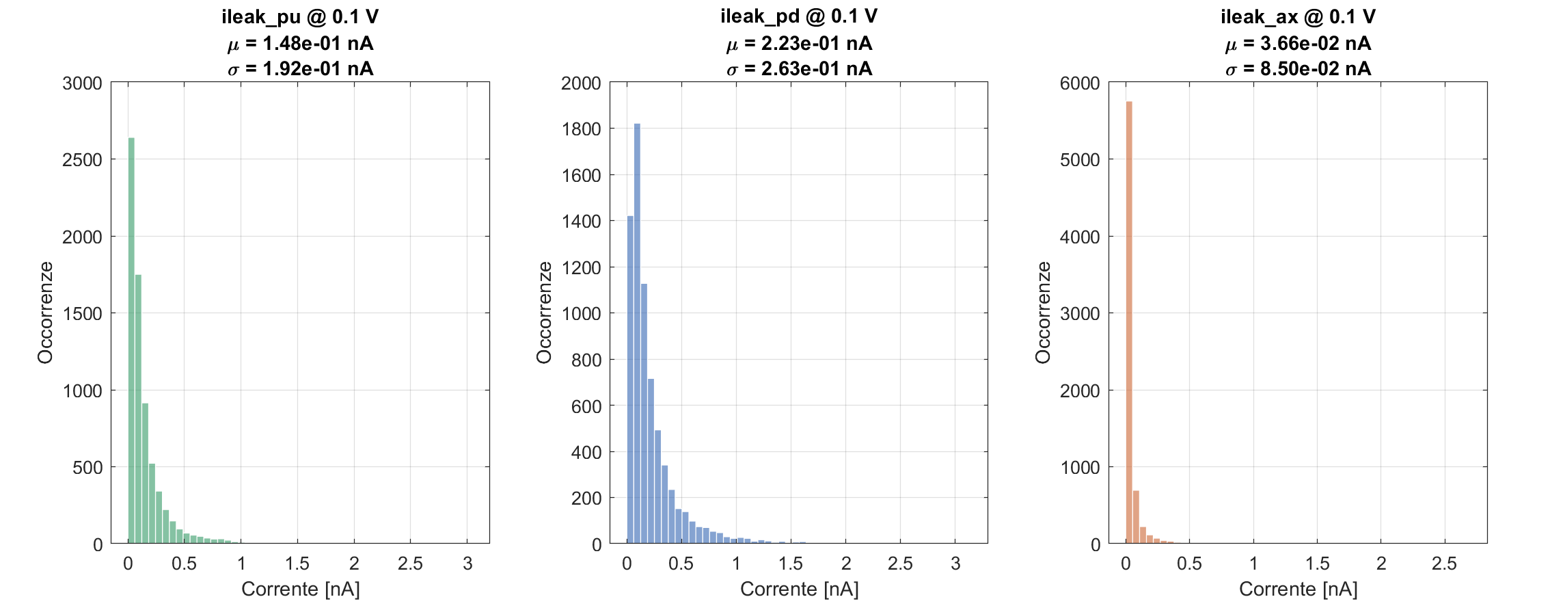
[picture p24: figure]

### 4.3.2 Andamento globale e potenza dissipata

L’analisi complessiva delle medie statiche `e mostrata in Figura 21. Come previsto, all’abbassarsi della tensione le correnti calano drasticamente; si nota inoltre come la componente di accesso sia trascurabile rispetto alle altre, grazie all’effetto body e alla tensione VDS nulla in fase di hold.

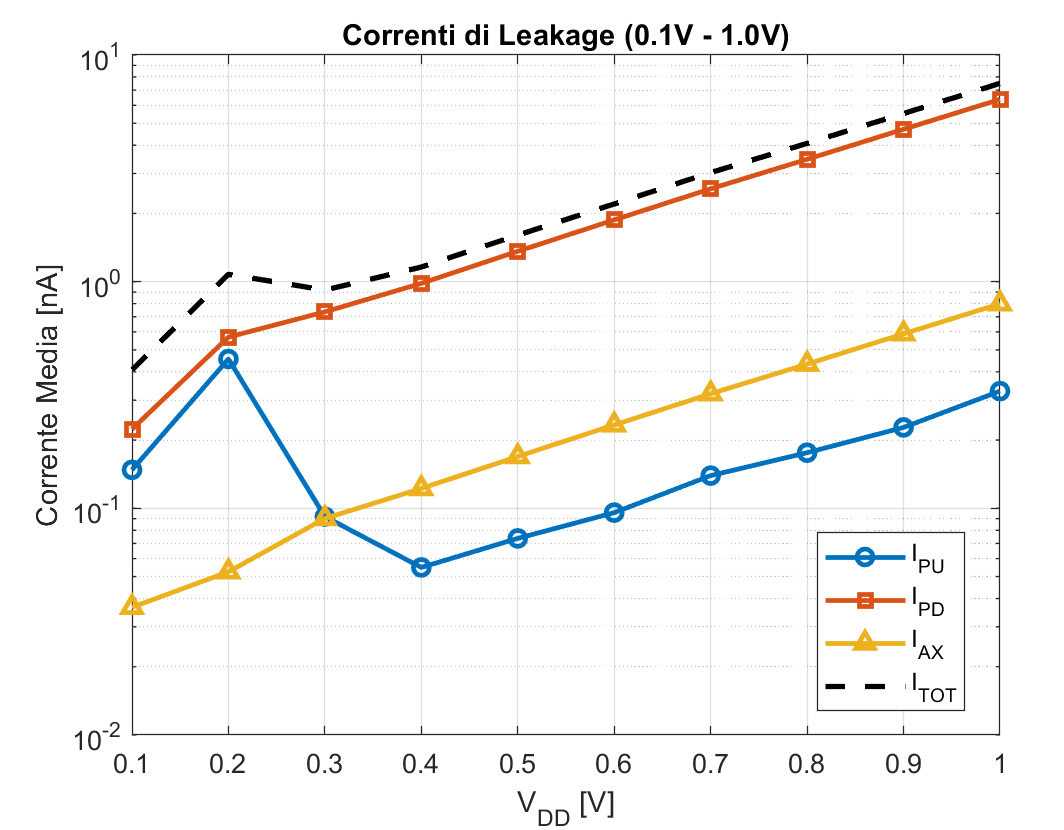
[picture p25: figure]

Figura 21: Andamento delle correnti di leakage medie in scala logaritmica.

Infine, lo scaling della potenza di leakage media totale (Pleak = Ileaktot · VDD) `e riportato in Figura 22. Si nota come il risparmio di potenza sia di diversi ordini di grandezza scendendo verso il limite di operativit`a della cella.

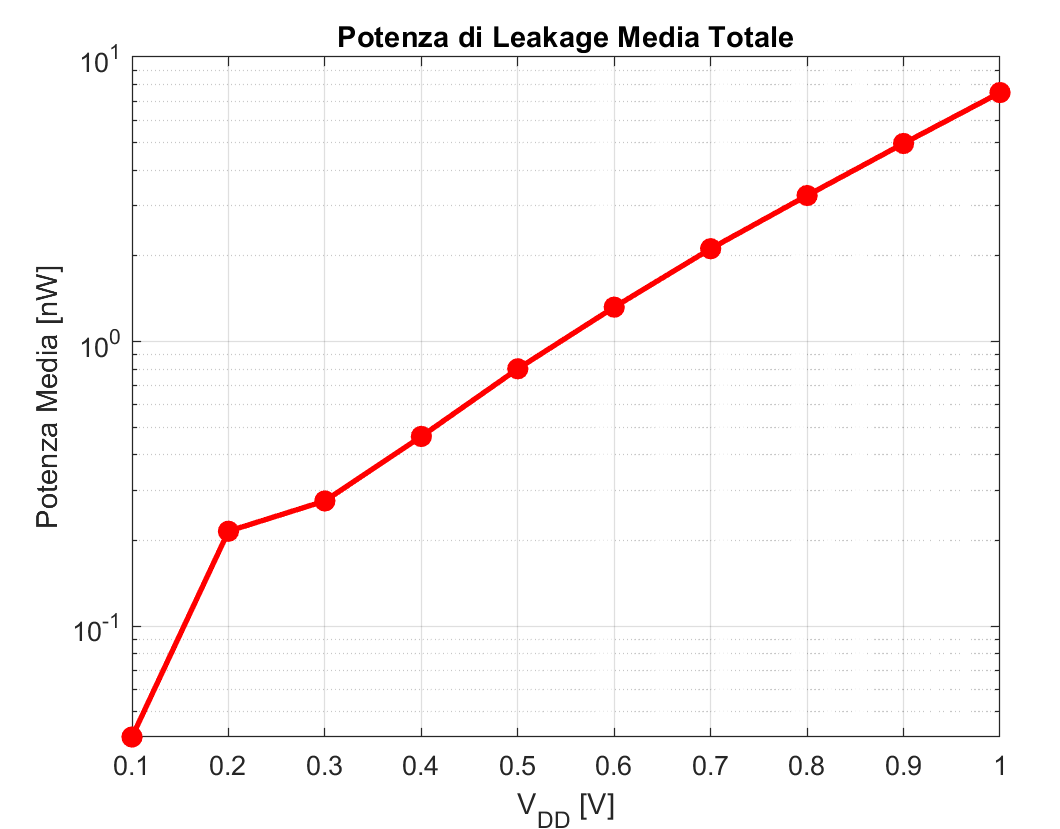
[picture p26: figure]

Figura 22: Scaling della potenza di leakage media totale al variare di VDD.

Ecco una tabella riassuntiva di tutti i valori delle correnti di leakage trovati:

VDD [V] | IP U [nA] | IP D [nA] | IAX [nA] | IT OT [nA] PT OT [nW]
1.0 | 0.33 ± 0.75 | 6.37 ± 11.39 | 0.80 ± 1.46 | 7.50 | 7.50
0.9 | 0.23 ± 0.45 | 4.70 ± 9.05 | 0.59 ± 1.17 | 5.52 | 4.97
0.8 | 0.18 ± 0.37 | 3.47 ± 6.27 | 0.43 ± 0.80 | 4.08 | 3.26
0.7 | 0.14 ± 0.33 | 2.57 ± 4.73 | 0.32 ± 0.60 | 3.03 | 2.12
0.6 | 0.10 ± 0.19 | 1.87 ± 3.72 | 0.23 ± 0.47 | 2.20 | 1.32
0.5 | 0.07 ± 0.16 | 1.36 ± 2.52 | 0.17 ± 0.32 | 1.60 | 0.80
0.4 | 0.05 ± 0.11 | 0.98 ± 1.91 | 0.12 ± 0.24 | 1.16 | 0.46
0.3 | 0.09 ± 0.18 | 0.74 ± 1.40 | 0.09 ± 0.18 | 0.92 | 0.28
0.2 | 0.46 ± 0.26 | 0.57 ± 0.73 | 0.05 ± 0.13 | 1.08 | 0.22
0.1 | 0.15 ± 0.19 | 0.22 ± 0.26 | 0.04 ± 0.09 | 0.41 | 0.04

Tabella 1: Sintesi statistica del leakage al variare della tensione.

Dall’analisi sistematica delle componenti di corrente, emerge che il contributo predominante al leakage totale `e riconducibile al transistor di Pull-down (M1). Al contrario, i contributi derivanti dai transistor di accesso (M4) e di Pull-up (M2) risultano inferiori di almeno un ordine di grandezza.
Per quanto concerne i transistor di Pull-down e di accesso, si osserva una riduzione esponenziale della corrente al decrescere della tensione di alimentazione VDD, in linea con la teoria della conduzione di sottosoglia. Un comportamento peculiare si riscontra invece nel transistor di Pull-up: in seguito allo scaling nel range [0.2 V − 0.4 V ], si rileva un incremento esponenziale della corrente di leakage. Tale fenomeno `e fisicamente plausibile e imputabile alle ridotte dimensioni del dispositivo e al regime di sottosoglia profonda in cui opera; in tali condizioni, le variazioni della tensione di soglia e gli effetti di secondo ordine (come il Drain-Induced Barrier Lowering) possono portare a un incremento dei parassiti statici.
Tuttavia, questo aumento marginale della corrente di Pull-up non altera l’andamento globale della dissipazione: la potenza di leakage complessiva continua a diminuire drasticamente al decrescere di VDD, come mostrato in Figura 22. Si pu`o dunque concludere che la riduzione della tensione di alimentazione rappresenti la strategia pi`u efficace per il contenimento della potenza statica, garantendo un risparmio energetico di diversi ordini di grandezza.

## 5 Analisi del Data Retention Voltage (DRV)

Il Data Retention Voltage (DRV) `e definito come la tensione minima di alimentazione alla quale una cella SRAM riesce a mantenere correttamente lo stato logico memorizzato. Il superamento di questo limite durante lo scaling della VDD comporta la perdita del dato (flipping della cella), rendendo il DRV il parametro critico per definire il limite operativo in modalit`a standby.
Per garantire la robustezza del sistema, `e necessario che la condizione VDD > DRV sia sempre soddisfatta. Nella pratica industriale, si aggiunge solitamente un margine di sicurezza ( safety margin) di circa 100 mV per compensare variazioni termiche, rumore di alimentazione o fluttuazioni locali del processo non modellate dalla simulazione.

### 5.1 Risultati statistici e Yield

L’analisi `e stata condotta monitorando il numero di celle fallite su un campione di 7000 run Monte Carlo per ogni step di tensione. Un fallimento viene registrato quando l’HSNM scende al di sotto della soglia di sicurezza di 60 mV . I risultati sono sintetizzati nella Tabella 2.

Tabella 2: Analisi dei fallimenti e stima dello Yield al variare della VDD.

VDD [V] # Celle Fallite (Flipped) # Celle con HSNM < 60 mV

1.0 | 0 | 0
0.9 | 0 | 0
0.8 | 0 | 0
0.7 | 0 | 0
0.6 | 0 | 0
0.5 | 0 | 0
0.4 | 1 | 1
0.3 | 712 | 713
0.2 | 5091 | 5804

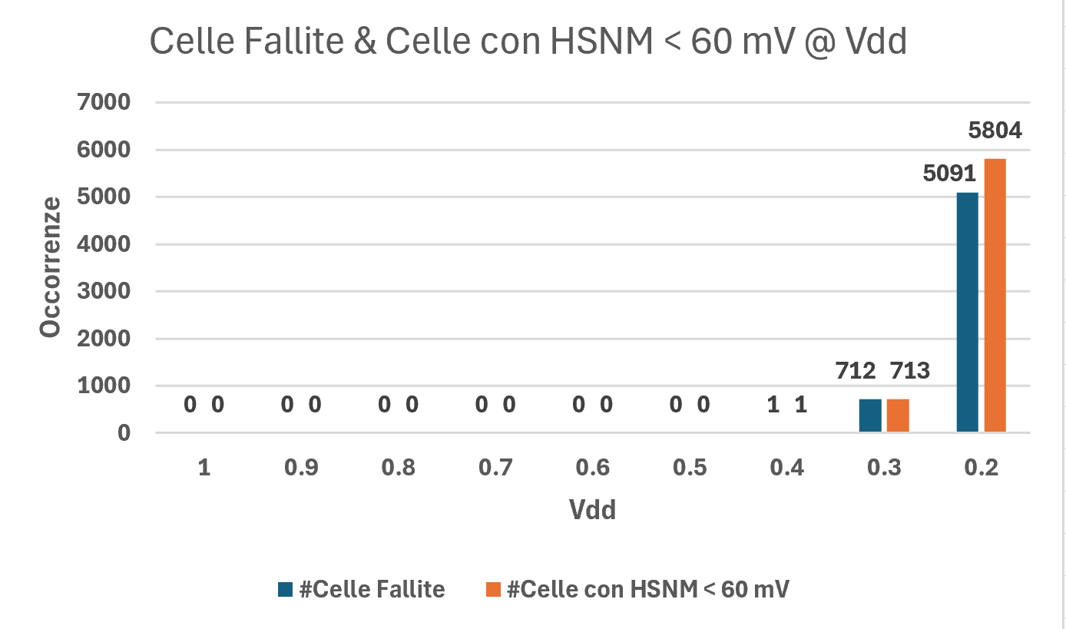
[picture p27: figure]

Come si evince dai dati, la cella presenta uno Yield del 100% fino a 0.5 V . Il primo cedimento statistico si verifica a 0.4 V , mentre a tensioni inferiori il tasso di fallimento diventa inaccettabile (> 10% a 0.3 V e > 70% a 0.2 V ). Sulla base di queste osservazioni, il DRV statistico della cella pu`o essere fissato a 0.4 V . Applicando il margine di sicurezza di 100 mV , si determina che la tensione di alimentazione minima sicura per questa specifica implementazione SRAM `e pari a 0.5 V. Questo punto di lavoro garantisce la massima efficienza energetica (riducendo drasticamente il leakage, come visto nel capitolo precedente) senza compromettere l’integrit`a dei dati memorizzati.
