ClerckMaxwell/6T-SRAM-Design-an-Reliability-Analysis/Schematics/6tcell.asc

M1: nmos4; EECMOSN; l=0.12u w=0.5u
M2: pmos4; EECMOSP; l=0.12u w=0.12u
M3: nmos4; EECMOSN; l=0.12u w=0.5u
M4: nmos4; EECMOSN; l=0.12u w=0.9u
M5: pmos4; EECMOSP; l=0.12u w=0.12u
M6: nmos4; EECMOSN; l=0.12u w=0.9u
V1: voltage; 1
V2: voltage; 1
V3: voltage; 1
V4: voltage; 1
Vsweep: voltage; 1
Named nets: 0, Q, WL, Qneg, BLneg, BL
.inc C:\\Users\\raffy\\Documents\\LTSpice projects\\low_p\\RIT_Models_For_LTSPICE.txt
.dc Vsweep 0 1 0.01
