ClerckMaxwell/6T-SRAM-Design-an-Reliability-Analysis/Schematics/6tcell_leak.asc

M1: nmos4; EECMOSN; l=0.12u w={wpd}
M2: pmos4; EECMOSP; l=0.12u w={wpu}
M3: nmos4; EECMOSN; l=0.12u w={wpd}
M4: nmos4; EECMOSN; l=0.12u w={wax}
M5: pmos4; EECMOSP; l=0.12u w={wpu}
M6: nmos4; EECMOSN; l=0.12u w={wax}
V1: voltage; PWL(11n 0 11.005n {Vdd})
V2: voltage; {Vdd}
V3: voltage; {Vdd}
V4: voltage; PULSE(0 {Vdd} 5n 5p 5p 5n 0n 1)
Named nets: WL, 0, Q, Qneg, BLneg, BL
.inc C:\\Users\\raffy\\Documents\\LTSpice projects\\low_p\\RIT_Models_For_LTSPICE_MonteCarlo.txt
.step param Vdd 0.1 1 0.1
.step param run 1 7000 1
.save Id(M2) Is(M4) Id(M1)
.tran 0 25n 0
.meas TRAN Ileak_pu FIND abs(Id(M2)) AT 24n
.meas TRAN Ileak_pd FIND abs(Id(M1)) AT 24n
.meas TRAN Ileak_ax FIND abs(Is(M4)) AT 24n
.param wpu 0.12u
.param wpd 0.5u
.param wax 0.12u
