ClerckMaxwell/6T-SRAM-Design-an-Reliability-Analysis/Schematics/seevnick_hold.asc

E1: e; 0.707
E2: e; 0.707
E3: e; 1
E4: e; 1.414
E5: e; 0.707
E6: e; -0.707
E7: e; -1
E8: e; 1.414
M1: nmos4; EECMOSN; l=0.12u w=0.5u
M2: pmos4; EECMOSP; l=0.12u w=0.12u
M3: nmos4; EECMOSN; l=0.12u w=0.5u
M5: pmos4; EECMOSP; l=0.12u w=0.12u
Vdc: voltage; {Vdd}
Vsweep: voltage; 1
Named nets: 0, U, Vout1, Vout2, V2, V1, supply
.inc C:\\Users\\raffy\\Documents\\LTSpice projects\\low_p\\RIT_Models_For_LTSPICE.txt
.dc Vsweep -0.707 0.013 0.01
.meas DC hsnm_seevnick  MAX(0.707*V(v1)-0.707*V(v2))
.step param run 1 7000 1
.param Vdd 1
.save V(v1) V(v2)
