ClerckMaxwell/6T-SRAM-Design-an-Reliability-Analysis/Schematics/seevnick_read.asc

E1: e; 0.707
E2: e; 0.707
E3: e; 1
E4: e; 1.414
E5: e; 0.707
E6: e; -0.707
E7: e; -1
E8: e; 1.414
M1: nmos4; EECMOSN; l=0.12u w=0.375u
M2: pmos4; EECMOSP; l=0.12u w=0.12u
M3: nmos4; EECMOSN; l=0.12u w=0.375u
M4: nmos4; EECMOSN; l=0.12u w={Wax}
M5: pmos4; EECMOSP; l=0.12u w=0.12u
M6: nmos4; EECMOSN; l=0.12u w={Wax}
V2: voltage; {Vdd}
V4: voltage; {Vdd}
V5: voltage; {Vdd}
Vsupply: voltage; {Vdd}
Vsweep: voltage; 1
Named nets: 0, U, Vout1, Vout2, V2, V1, WL, supply
.inc C:\\Users\\raffy\\Documents\\LTSpice projects\\low_p\\RIT_Models_For_LTSPICE.txt
.dc Vsweep -0.707 0.15 0.01
.meas DC rsnm_seevnick MAX (0.707*V(v1)-0.707*V(v2))
.step param run 1 7000 1
.save V(v1) V(v2)
.param Vdd 1
