ClerckMaxwell/6T-SRAM-Design-an-Reliability-Analysis/(commit log)

2026-01-28 Remove file Schematics/gg
2026-01-28 Revise safety margin in DRV conclusion
    Updated the safety margin in the conclusion for Minimum Safe Supply Voltage.
